JustinOng/Robot-Rugby/img/kicker_hall_effect.JPG

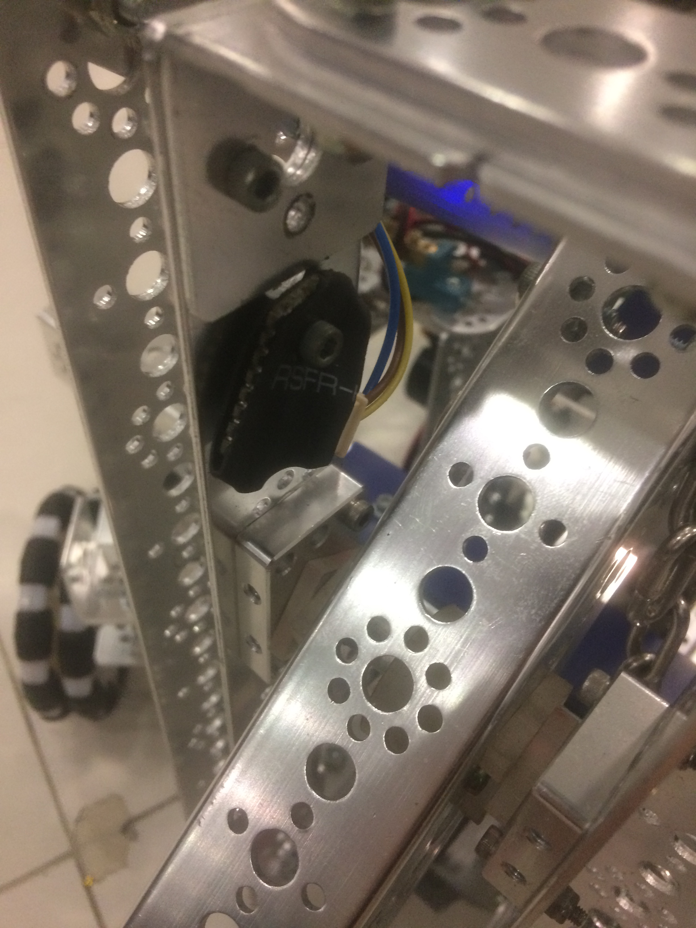
img/kicker_hall_effect.JPG
