JustinOng/Robot-Rugby/controller/Receiver.h

#ifndef ReceiverIncluded
#define ReceiverIncluded

#include <Arduino.h>

#define SCALE_MIN -100
#define SCALE_MAX 100

class ReceiverClass {
  private:
    volatile uint32_t last_rising_edge = 0;

    int16_t min[4] = {
      419,
      360,
      368,
      323
    };

    int16_t max[4] = {
      1732,
      1673,
      1680,
      1635
    };

    int16_t ctr[4] = {
      1067,
      1014,
      1024,
      980
    };

    uint8_t invert[4] = {
      1,
      0,
      0  ,
      1
    };
    
  public:
    ReceiverClass(void);
    void begin(void);
    void loop(void);

    int16_t get_channel(uint8_t channel);
    uint16_t lostFrames = 0;
  private:
    uint16_t channels[16];
    uint8_t failSafe = 1;
    
    int16_t scale(int16_t value, uint8_t channel);
};

extern ReceiverClass Receiver;

#endif
