JustinOng/Robot-Rugby/(commit log)

2016-09-20 Called attachInterrupt with explicit .begin() function rather than at class init(which causes the teensy to lock up)
2016-09-20 Declared pin directions
2016-09-21 Added MotorsClass to handle setting power of motors
2016-09-23 hardcoded values for testing A4973 motor driver with the receiver
2016-09-28 added driver/field centric control
2016-10-15 added solenoid control on falling edge of CH5
2016-10-18 removed pwm pulse counting for sbus
2016-10-24 added solenoid control on CH9
2016-10-26 converted arduino project to platformio project
2016-10-26 corrected failsafe byte to 0x0C
    [SBUS.cpp, SBUS.h]
2016-11-04 added support for lift and gripper solenoid
2016-11-07 Configured futaba transmitter to utilitise all 10 buttons
2016-11-07 swapped Lift and Winch motor index for troubleshooting
    [Motors.h]
2016-11-07 Added test for ws2812b LEDs
2016-11-07 created Battery_Monitor_Class to control ws2812b's based on the individual cell voltages
2016-11-13 swapped motor index of Lift and Winch back to original
    [Motors.h]
2016-11-16 added control for MCP23008 driver to control lasers
2016-11-16 fixed logical errors in edge detection
    [Receiver.cpp]
2016-11-21 average the last 10 adc readings to prevent value from jumping around
    [Battery_Monitor.cpp, Battery_Monitor.h]
2016-11-21 limited max position of lift with hall effect sensor
2016-11-27 added NewPing to handle ultrasonic sensors
2016-11-27 updated pin definitions to match new controller board
2016-11-27 pin 24 has a hardware pull down which disables all motors, needs to be set high to enable (used to stop "jerk" on robot startup)
2016-11-27 added test code for ultrasonic sensors
2016-11-27 send command to driver only if value was changed
2016-11-27 shifted pin config to pin_config.h
2016-11-27 motor throttling moved to MotorsClass from main controller
2016-11-27 named MOTOR_ENABLE_PIN
2016-11-27 moved ultrasonic code to TeeAlignerClass
2016-11-28 fixed minor declaration issues
    [TeeAligner.cpp, TeeAligner.h]
2016-11-28 fixed method declaration issues
    [TeeAligner.h]
2016-11-28 turned on the lasers when kicker is loaded
2016-11-28 Added current monitor to read cs voltage from motors
2016-11-28 commented out current monitor information
2016-11-29 implemented PI controller for tee aligner. works reasonably well with oscillations if allowed to run for more than a few seconds.
    [TeeAligner.cpp, TeeAligner.h, main.cpp]
2016-11-29 implemented control of servo gripper
2016-12-02 implemented PID control for left and right motor drives to align to tee.
2016-12-02 disabled teealigner because ball on tee was causing variations in the distance measured by the ultrasonic sensor.
2016-12-02 added control of gripper servo
2016-12-02 invert right channel when forward channel is inverted too
    [main.cpp]
2016-12-05 defined KICKER_HALL_EFFECT_THRESHOLD and added timer to track when was the kicker last loaded
2016-12-05 added control for relay that switches servo power
2016-12-05 modified control for servo
2016-12-05 renamed ULTRASONIC_1_PIN to SERVO_RELAY_PIN since its reused for relay control
2016-12-06 added 1s cooldown for solenoid trigger
2016-12-06 limited lift with hall effect A1 at the top and encoder counts at the bottom
2016-12-06 fixed bug with auto reload not working
    [main.cpp]
2016-12-06 cut power to the servo when claw is in "closed" state which is pulled by spring to prevent excessive heating
    [main.cpp]
2016-12-06 added i2cdev library
2016-12-07 added GyroClass to manage the MPU6050
2016-12-07 init wire bus with mcp.begin() before calling Gyro.begin()
2016-12-07 added driver centric control back
2016-12-07 removed driver centric control as my driver was getting confused
2016-12-08 adjusted servo values
2016-12-08 Revert "removed driver centric control as my driver was getting confused"
    This reverts commit d24da05d92b40e4cd90f17bae33ef6f034befda3.
    [main.cpp]
2016-12-13 disabled battery monitor since it wasnt functioning properly. using external module that plugs into balance leads for warning now.
2016-12-13 put servo into inactive state when controller is not detected
2016-12-13 used the 3 lights meant for displaying battery voltage to display status of receiver on the first one
2016-12-13 added Christmas_Tree_Class which handles the lighting of the christmas tree, currently used to indicate whether controls are inverted when in field centric mode. Green tree meaning not inverted, Red 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
    [Christmas_Tree.cpp, Christmas_Tree.h, main.cpp]
2016-12-13 added different limits for how low the lift can go, when channel 7 is not active assume "not in competition mode" which lets the lift go all the way down. channel 7 active limits the lift such that t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
2016-12-13 reallocated servo relay and motor enable pins so that they use only the through hole pins of the teensy
2016-12-13 renamed BATT_LED_BRIGHTNESS to LED_BRIGHTNESS
2016-12-13 disabled current monitor
2016-12-13 use kicker hall effect sensor to determine whether the kicker is loaded instead of assuming the solenoid has activated successfully
2016-12-13 limited the speed of the lift when approaching the top hall effect sensor
2016-12-13 debug mode can be enabled by holding down the solenoid trigger for the first time the receiver connects to the transmitter. when in debug mode, channel 8 == 1 makes channel 3 move the winch, channel 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
2016-12-14 lowered error threshold for P controller of lift and scaled power instead of replacing it
    [main.cpp]
